chrisdaun/esp32-homespan-garagedoor-opener/YD-ESP32-S3_v2.jpeg

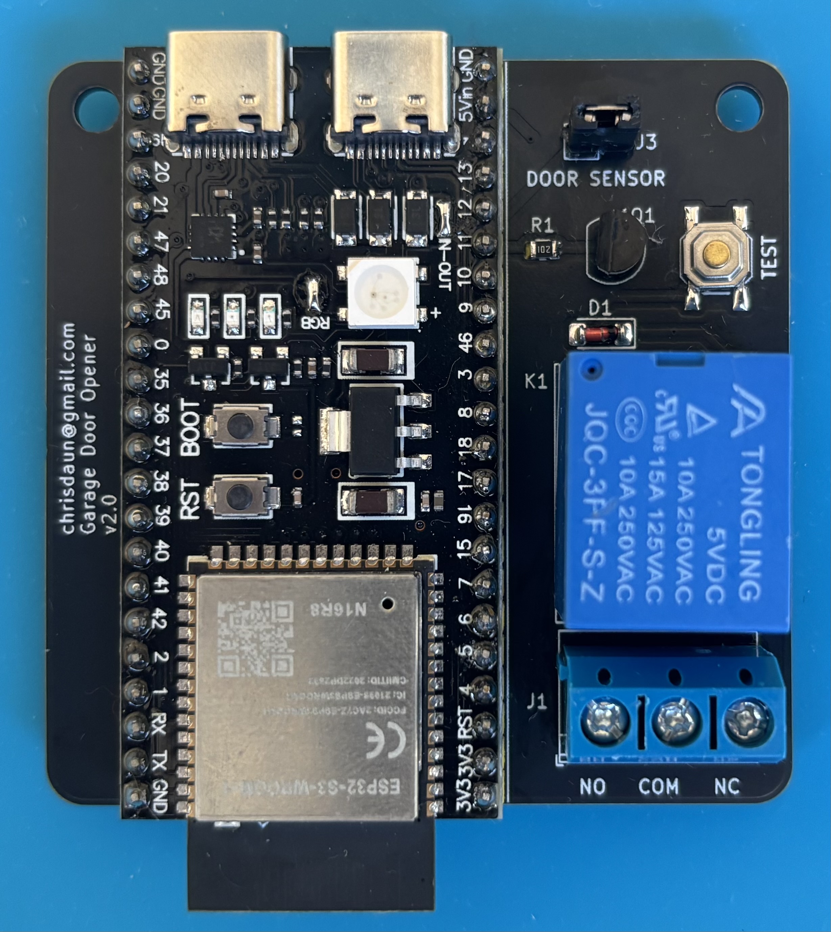
YD-ESP32-S3_v2.jpeg
