chrisdaun/esp32-homespan-garagedoor-opener/KiCAD/Garage Door Opener/Garage Door Opener.kicad_pcb

## KiCad design KiCAD/Garage Door Opener/Garage Door Opener.kicad_pcb (2024-11-21)

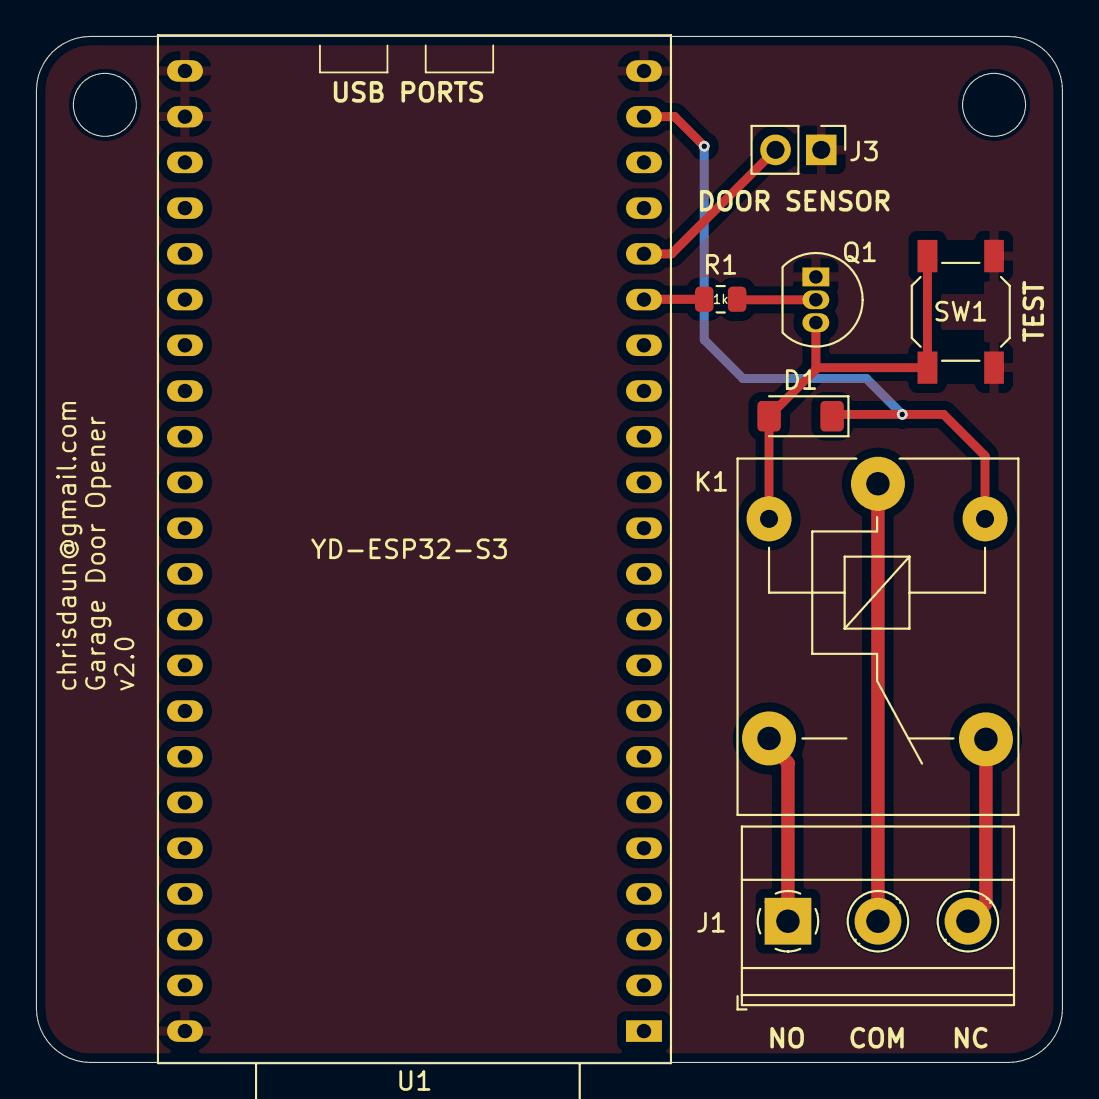
[picture p2: board Garage Door Opener.kicad_pcb from above]

Board: 2 copper layers, 57.0 x 57.0 mm, 10 parts (0 on the bottom side), 9 nets.

Parts:
D1: D; D_MiniMELF
H1, H2: MountingHole; MountingHole_3.5mm
J1: Screw_Terminal_01x03; TerminalBlock_Phoenix_MKDS-1,5-3_1x03_P5.00mm_Horizontal
J3: Conn_01x02_Pin; PinHeader_1x02_P2.54mm_Vertical
K1: JQC-3FF-S-Z
Q1: PN2222A; TO-92_Inline
R1: 1kOhm; R_0805_2012Metric
SW1: SW_Push; SW_SPST_SKQG_WithStem
U1: YD-ESP32-S3

Connections:
+5V: D1.1 (K), K1.1 (VCC), U1.21 (5V)
/Common: J1.2, K1.3 (Common)
/Normally Closed: J1.3, K1.4 (Normally_Closed)
/Normally Open: J1.1, K1.5 (Normally_Open)
GND: J3.1, Q1.1 (E), SW1.2, U1.22 (GND), U1.23 (GND), U1.24 (GND), U1.44 (GND)
unnamed: D1.2 (A), K1.2 (GND), Q1.3 (C), SW1.1
unnamed: J3.2, U1.18 (GPIO12/ADC2_CH1)
unnamed: Q1.2 (B), R1.2
unnamed: R1.1, U1.17 (GPIO11/ADC2_CH0)
