chrisdaun/esp32-homespan-garagedoor-opener/(commit log)

2024-11-05 Adding custom board design
    [Garage Door Opener-B_Cu.gbr, Garage Door Opener-B_Mask.gbr, Garage Door Opener-B_Paste.gbr, Garage Door Opener-B_Silkscreen.gbr, Garage Door Opener-Edge_Cuts.gbr, Garage Door Opener-F_Cu.gbr, Garage Door Opener-F_Mask.gbr, Garage Door Opener-F_Paste.gbr]
2024-11-21 Updated board design
    [Garage Door Opener-B_Cu.gbr, Garage Door Opener-B_Mask.gbr, Garage Door Opener-B_Paste.gbr, Garage Door Opener-B_Silkscreen.gbr, Garage Door Opener-Edge_Cuts.gbr, Garage Door Opener-F_Cu.gbr, Garage Door Opener-F_Mask.gbr, Garage Door Opener-F_Paste.gbr]
2024-12-02 Updated logic levels for the YD board being used
